rdpowers/OHMC2022/Hardware/Documents/FPGAPinMap.ods

Pin Number | Pin Name Kicad Library | PKL Lattice Lib | Function | Power Bank | Voltage Level | Primary | Secondary | OHMC2022 Proposed | FOMU | iCEBreaker Bitsy | COMMENT
1 | VCCIO_2 | VCCIO_2 | Power input |  |  |  |  |  |  |  |  | Matches FOMU
2 | IOB_6a | IOB_6A | Bidirectional | VCCIO_2 |  |  |  |  |  |  |  | Deviates FOMU
3 | IOB_9b | IOB_9B | Bidirectional | VCCIO_2 |  |  |  |  | TOUCH1 |  |  | New function not in FOMU
4 | IOB_8a | IOB_8A | Bidirectional | VCCIO_2
5 | VCC | VCC | Power input
6 | IOB_13b | IOB_13B | Bidirectional
7 | CDONE | CDONE | Open collector | SPI_VCCIO_1 | 3.3 |  |  | SAO PIN5 | CDONE |  | Wired to ESP32 so we can know programming status, can be a general IO in user function?? Includes weak pull-up to vccio_1
8 | ~CRESET | CRESET_B | Input | SPI_VCCIO_1 | 3.3 |  |  | SAO PIN6 | ~CRESET |  | Wired to ESP32 so we can kick the FPGA, drive externally or pullup to vccio_1
9 | IOB_16a | IOB_16A | Bidirectional
10 | IOB_18a | IOB_18A | Bidirectional
11 | IOB_20a | IOB_20A | Bidirectional
12 | IOB_22b | IOB_22A | Bidirectional |  |  |  |  |  |  |  | LATTICE LIBRARY COMPONENT HAS THIS AS IOB_22A, so does iCEBreaker.
13 | IOB_24a | IOB_24A | Bidirectional |  |  |  |  | Flash SPI IO3 Hold
14 | IOB_32a_SPI_SO | IOB_32a_SPI_SO | Bidirectional | SPI_VCCIO_1 | 3.3 |  |  | Flash SPI MOSI |  |  | Can be general I/O in user function
15 | IOB_34a_SPI_SCK | IOB_34a_SPI_SCK | Bidirectional | SPI_VCCIO_1 | 3.3 |  |  | Flash SPI SCK |  |  | Can be general I/O in user function
16 | IOB_35b_SPI_SS | IOB_35b_SPI_CSN | Bidirectional | SPI_VCCIO_1 | 3.3 |  |  | Flash SPI CS |  |  | Can be general I/O in user function
17 | IOB_33b_SPI_SI | IOB_33b_SPI_SI | Bidirectional | SPI_VCCIO_1 | 3.3 |  |  | Flash SPI MISO |  |  | Can be general I/O in user function
18 | IOB_31b | IOB_31B | Bidirectional | SPI_VCCIO_1
19 | IOB_29b | IOB_29B | Bidirectional | SPI_VCCIO_1
20 | IOB_25b_G3 | IOB_25B_G3 | Bidirectional | SPI_VCCIO_1 |  |  |  | Flash SPI IO2 WP
21 | IOB_23b | IOB_23B | Bidirectional | SPI_VCCIO_1
22 | SPI_VCCIO1 | SPI_VCCIO1 | Power input
23 | IOT_37a | IOT_37A | Bidirectional | VCCIO_0 |  |  |  | USB D-
24 | VPP_2V5 | VPP_2V5 | Power input
25 | IOT_36b | IOT_36B | Bidirectional | VCCIO_0 |  |  |  | USB D+
26 | IOT_39a | IOT_39A | Bidirectional | VCCIO_0 |  |  |  | PU_CTRL_USBP |  |  | Don’t have IOT_47a
27 | IOT_38b | IOT_38B | Bidirectional | VCCIO_0
28 | IOT_41a | IOT_41A | Bidirectional | VCCIO_0
29 | VCCPLL | VCCPLL | Power output
30 | VCC | VCC | Passive
31 | IOT_42b | IOT_42B | Bidirectional | VCCIO_0
32 | IOT_43a | IOT_43A | Bidirectional | VCCIO_0
33 | VCCIO_0 | VCCIO_0 | Power input
34 | IOT_44b | IOT_44B | Bidirectional | VCCIO_0
35 | IOT_46b_G0 | IOT_46B_G0 | Bidirectional | VCCIO_0 |  |  |  | INPUT CLOCK |  |  | We don’t have IOB_11b_G5 on this package like FOMU. Need to feed base clock to on of the *_G[0..7] lines. ICEBreaker used this pin @12MHz
36 | IOT_48b | IOT_48B | Bidirectional | VCCIO_0
37 | IOT_45a_G1 | IOT_45A_G1 | Bidirectional | VCCIO_0 |  |  |  |  |  | USB_DET
38 | IOT_50b | IOT_50B | Bidirectional | VCCIO_0 |  |  |  |  |  | USB D-
39 | RGB0 | RGB0 | Open collector |  |  |  |  | LED GREEN | LED GREEN
40 | RGB1 | RGB1 | Open collector |  |  |  |  | LED RED | LED RED
41 | RGB2 | RGB2 | Open collector |  |  |  |  | LED BLUE | LED BLUE
42 | IOT_51a | IOT_51A | Bidirectional | VCCIO_0 |  |  |  |  |  | USB D+
43 | IOT_49a | IOT_49A | Bidirectional | VCCIO_0
44 | IOB_3b_G6 | IOB_3B_G6 | Bidirectional | VCCIO_2 |  |  |  |  | TOUCH4
45 | IOB_5b | IOB_5B | Bidirectional | VCCIO_2
46 | IOB_0a | IOB_0A | Bidirectional | VCCIO_2 |  |  |  |  | TOUCH3
47 | IOB_2a | IOB_2A | Bidirectional | VCCIO_2 |  |  |  |  | TOUCH2
48 | IOB_4a | IOB_4A | Bidirectional | VCCIO_2
49 | GND | PAD/GND | Power input |  | 0
 |  |  |  |  |  | MISSING vs. FOMU |  | IOB_11b_G5 | OSC Input on SPI BANK, global clock
 |  |  |  |  |  |  |  | IOT_47a | PU_CTRL_USBP
 |  |  |  |  |  | TBA |  | i2s | Probably anywhere. Would be nice if mclk was possible on Global pin..
 |  |  |  |  |  |  |  | i2c | From ESP32, probably anywhere.
 |  |  |  |  |  |  |  | prototype | Can go anywhere. Connector? Pads?
 |  |  |  |  |  |  |  | i2c | Secondary FPGA master.
 |  |  |  |  |  |  |  | PU_CTRL_USBP/USB_DET
