rdpowers/OHMC2022/Hardware/Resources/PAM2306-VOTable.png

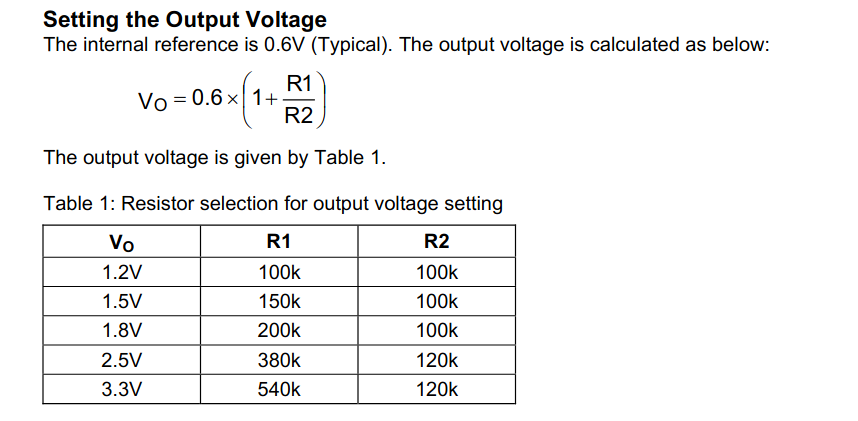
Hardware/Resources/PAM2306-VOTable.png
