rdpowers/OHMC2022/Hardware/Models/CW_SlideSwitch_GF-123-0054.step

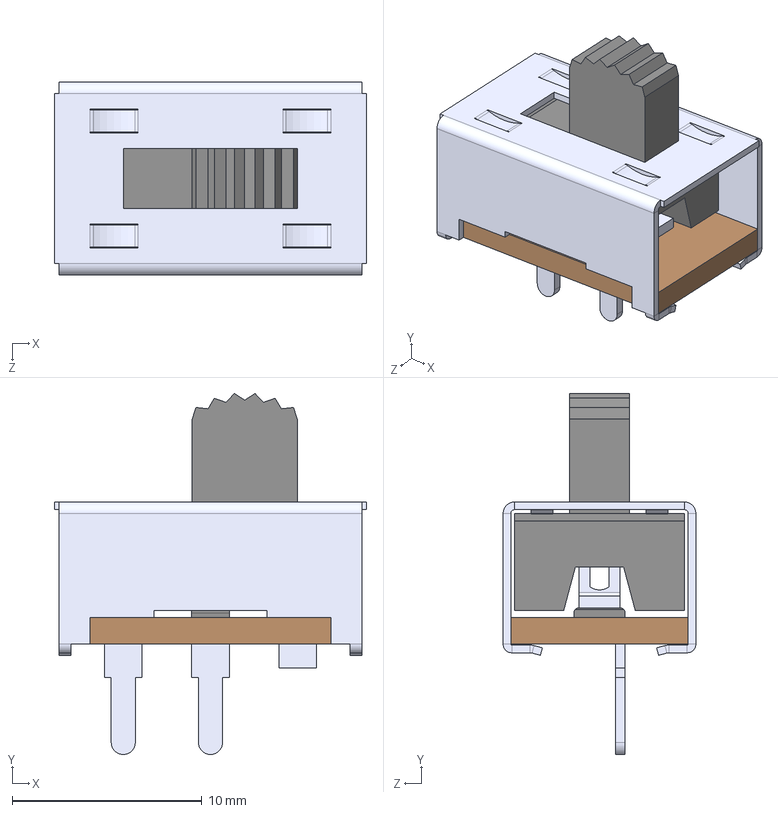
[picture p2: CAD file, 2021-09-02]
Hardware/Models/CW_SlideSwitch_GF-123-0054.step
16.5 x 19.0 x 10.2 mm
