rdpowers/OHMC2022/Hardware/Models/TRANS_EM6_ROM.SOT563.step

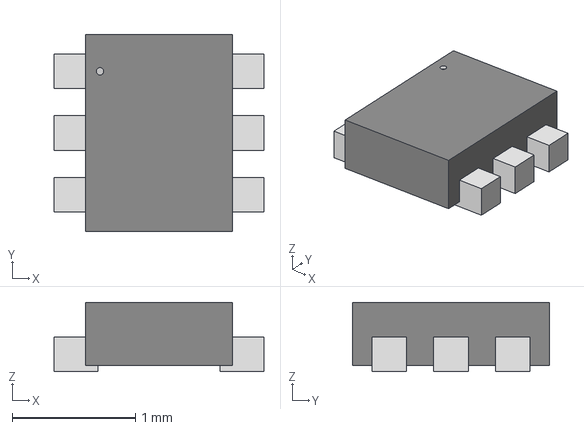
[picture p3: CAD file, 2021-09-02]
Hardware/Models/TRANS_EM6_ROM.SOT563.step
1.70 x 1.60 x 0.561 mm
