rdpowers/OHMC2022/Hardware/Models/TriLED.XZMDKCBDDG45S-9.step

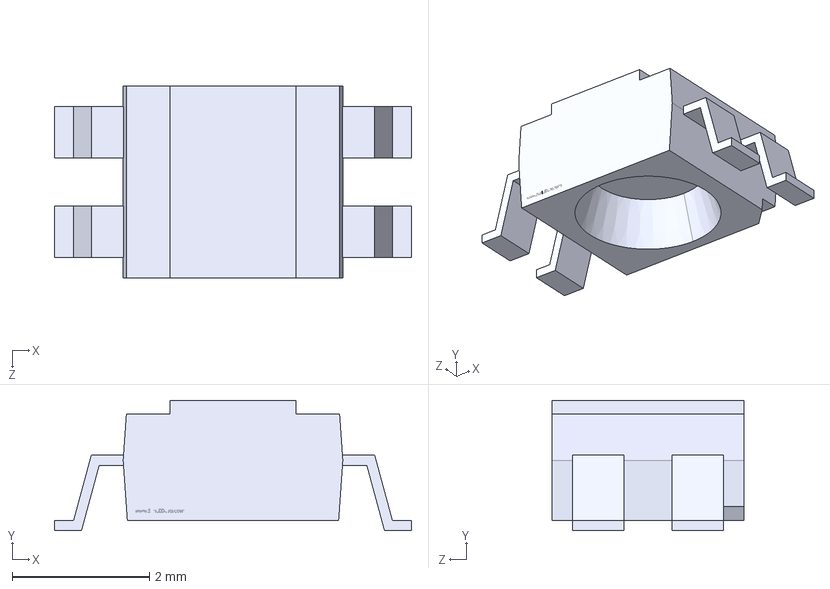
[picture p4: CAD file, 2021-08-31]
Hardware/Models/TriLED.XZMDKCBDDG45S-9.step
5.20 x 1.90 x 2.80 mm
