rdpowers/OHMC2022/Hardware/Models/19-337C_RSBHGHC-A88_4T.step

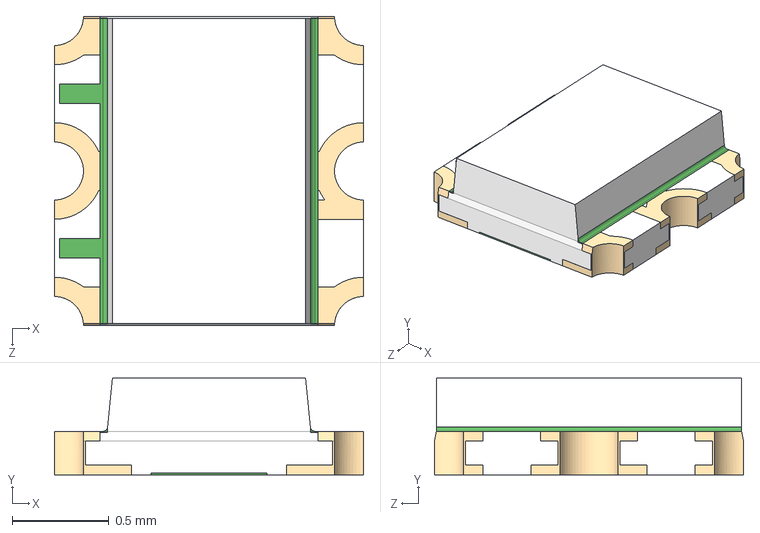
[picture p5: CAD file, 2021-08-30]
Hardware/Models/19-337C_RSBHGHC-A88_4T.step
1.60 x 0.5 x 1.60 mm
