rdpowers/OHMC2022/Hardware/Models/CUI_DEVICES_DS01-254-S-02BE.step

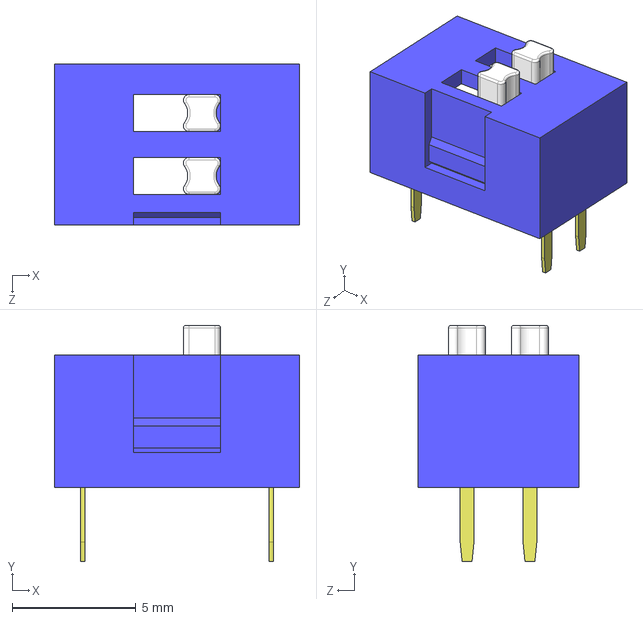
[picture p6: CAD file, 2021-08-30]
Hardware/Models/CUI_DEVICES_DS01-254-S-02BE.step
9.90 x 9.55 x 6.50 mm
