rdpowers/OHMC2022/Hardware/Models/EVQ-P7J01P.step

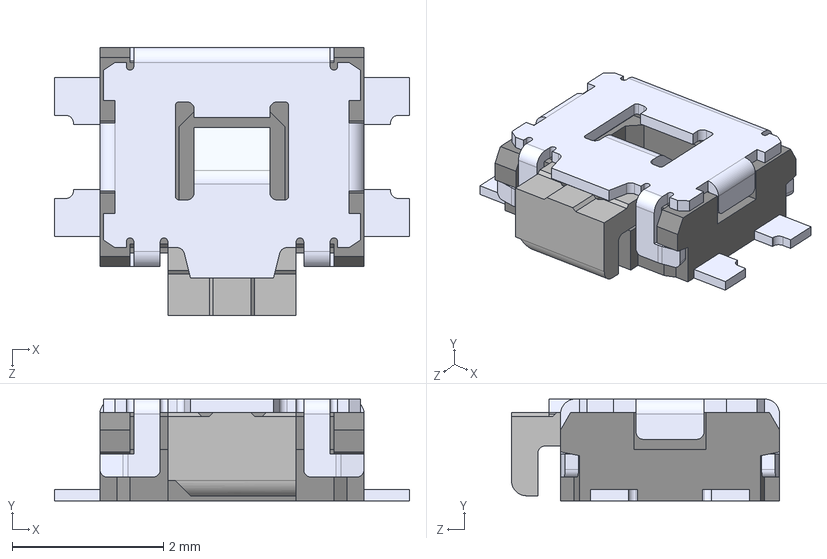
[picture p7: CAD file, 2021-08-29]
Hardware/Models/EVQ-P7J01P.step
4.70 x 1.35 x 3.55 mm
