rdpowers/OHMC2022/Hardware/Models/srn4018-4r7m.stp

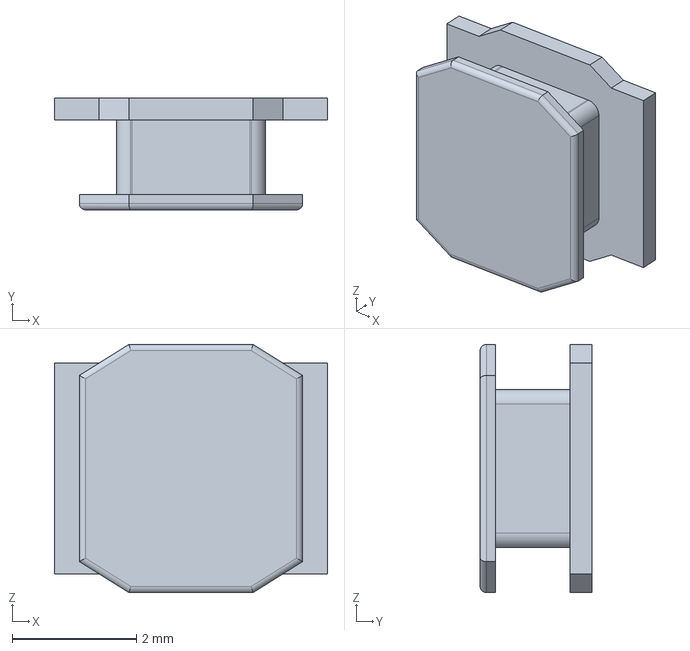
[picture p8: CAD file, 2021-08-29]
Hardware/Models/srn4018-4r7m.stp
4.40 x 1.80 x 4.00 mm
