rdpowers/OHMC2022/Hardware/Models/TSSOP14.HEF4069UBTT,118.STEP

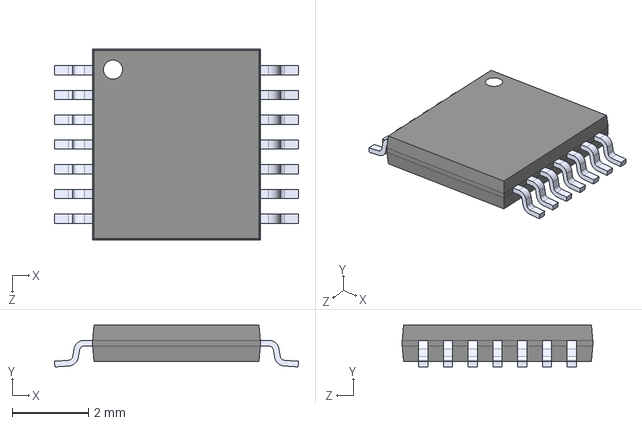
[picture p9: CAD file, 2021-08-28]
Hardware/Models/TSSOP14.HEF4069UBTT,118.STEP
6.40 x 1.10 x 5.00 mm
