rdpowers/OHMC2022/Hardware/Models/QFN50P250X350X100-17N.step

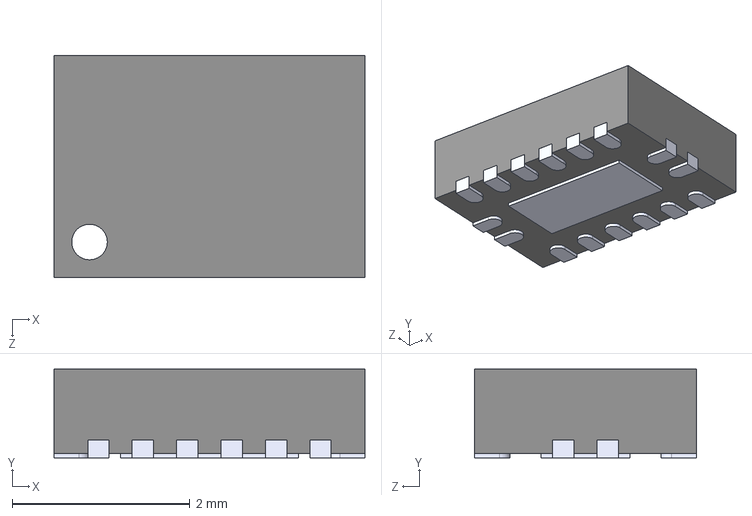
[picture p10: CAD file, 2021-08-28]
Hardware/Models/QFN50P250X350X100-17N.step
3.50 x 1.00 x 2.50 mm
