rdpowers/OHMC2022/Hardware/Models/IND_NL4532_TDK.step

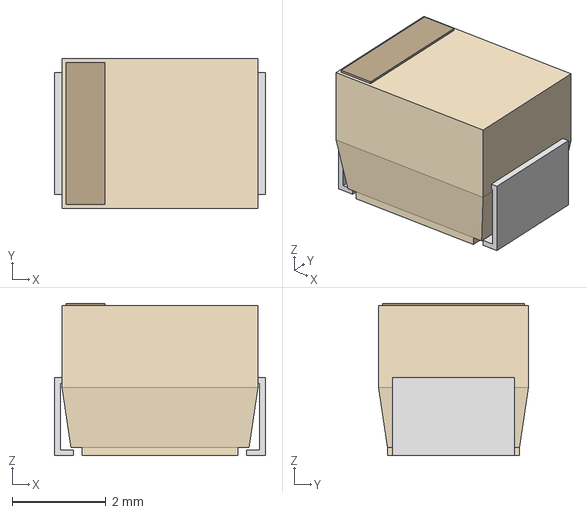
[picture p11: CAD file, 2021-08-28]
Hardware/Models/IND_NL4532_TDK.step
4.50 x 3.20 x 3.25 mm
