rdpowers/OHMC2022/Hardware/Models/Molex.uUSB-B.1050170001.stp

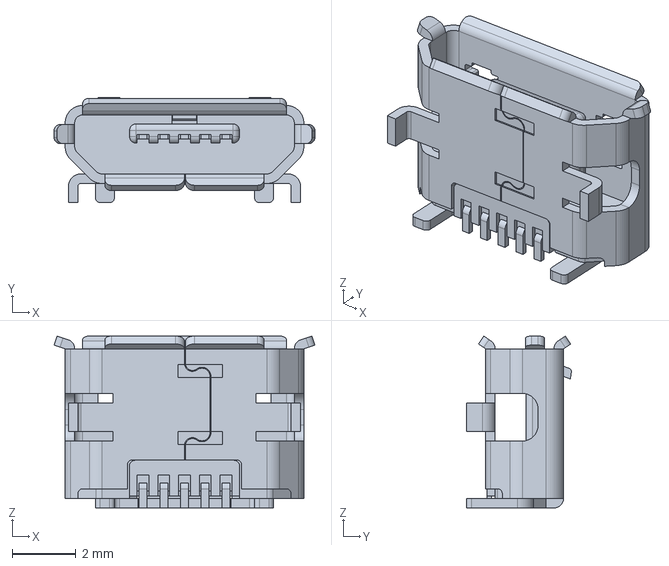
[picture p12: CAD file, 2021-08-27]
Hardware/Models/Molex.uUSB-B.1050170001.stp
8.20 x 3.30 x 5.40 mm
