rdpowers/OHMC2022/(threads)

Thread 2 (2021-10-03):

i2c0 net disconnect on top level sheet

rdpowers, 2021-10-03:
Missing net labels on top sheet means i2c0 doesn't go from SAO+ connector to FPGA/AFE blocks.

Closed 2021-11-08.

Thread 4 (2021-10-10):

Clock pin doesn't seem usable.

rdpowers, 2021-10-10:
Unresolved question about why _G0 pin doesn't pass synthesis. Other tested options are _G1 & _G3 on revision if this isn't remediated.

Closed 2021-11-08.

Thread 5 (2021-10-10):

Traces around USB connector.

rdpowers, 2021-10-10:
They're OK, but look weird. Fix them.

Closed 2021-11-08.

Thread 12 (2021-11-01):

Junction on L802 shouldn't be there.

rdpowers, 2021-11-01:
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

Guessing this got automatically added because the wire overlaps the pin? Awesome.

rdpowers, 2021-11-02:
Junction referenced is on Pin 1 of L802.

This line can be cut on the prototype.
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

Closed 2021-11-08.

Thread 13 (2021-11-08):

Did I fix the LED pinout issue?

rdpowers, 2021-11-08:

Closed 2021-11-08.
