rdpowers/OHMC2022/(commit log)

2021-08-22 Should probably put things in version control.
    [AFE.sch, Amplifier.sch, Audio.sch, Codec.sch, Connectors.sch, FPGA.sch, FPGAPinMap.ods, Power.sch]
2021-08-26 Getting down structure, some components created.
    [AFE.sch, Amplifier.sch, Audio.sch, Codec.sch, Connectors.sch, FPGA.sch, FPGAPinMap.ods, Power.sch]
2021-08-26 Checking in some libraries.
    [AFE.sch, FPGA.sch, Rockling.kicad_pcb, Rockling.sch]
2021-08-26 Moving some components around.
    [AFE.sch, FPGA.sch, Rockling.kicad_pcb, Rockling.sch]
2021-08-27 Adding libraries for TRRS.
    [FPGA.sch, Molex.uUSB-B.1050170001.stp, Rockling.kicad_pcb, Rockling.sch]
2021-08-27 Cleaning up a few associations, changing 0805 to 0603 footprints on AFE.
    [AFE.sch, Amplifier.sch, Audio.sch, Codec.sch, FPGA.sch, Power.sch, Rockling.kicad_pcb, Rockling.sch]
2021-08-28 Cleaning up some more, adding sourcing information.
    [AFE.sch, Rockling.kicad_pcb, Rockling.sch]
2021-08-28 Updating 4069 device to TSSOP14 package.
    [AFE.sch, IND_NL4532_TDK.step, QFN50P250X350X100-17N.step, TSSOP14.HEF4069UBTT,118.STEP]
2021-08-29 Adding in some power circuitry.
    [Power.sch, Rockling.sch]
2021-08-29 Now putting in power and passives.
    [Amplifier.sch, Power.sch, srn4018-4r7m.stp]
2021-08-29 Adding in a little more on the power circuitry, vreg for 2v5 rail.
    [Power.sch]
2021-08-29 We're going to need a bigger boat.
    [Power.sch, Rockling.kicad_pcb, Rockling.sch]
2021-08-29 Prospecting the layout of AFE, detailing connectors to larger board size.
    [EVQ-P7J01P.step, Power.sch, Rockling.kicad_pcb, Rockling.sch]
2021-08-29 Adding power to the 4069.
    [AFE.sch, Rockling.kicad_pcb, Rockling.sch]
2021-08-30 Checking in bits.
    [AFE.sch, FPGA.sch, Rockling.kicad_pcb, Rockling.sch]
2021-08-30 Adding 2-DIP switch.
    [CUI_DEVICES_DS01-254-S-02BE.step, FPGA.sch, Rockling.kicad_pcb, Rockling.sch]
2021-08-30 Adding some connectivity.
    [Audio.sch, Codec.sch, FPGA.sch, Rockling.kicad_pcb, Rockling.sch]
2021-08-30 Some passives to codec.
    [19-337C_RSBHGHC-A88_4T.step, Audio.sch, Codec.sch, Rockling.sch]
2021-08-30 Power connectivity going in.
    [Amplifier.sch, Codec.sch, Power.sch, Rockling.sch]
2021-08-31 Putting in some connectivity. More passives.
    [Amplifier.sch, Codec.sch, FPGA.sch, Power.sch, Rockling.kicad_pcb, Rockling.sch]
2021-08-31 More passives.
    [Audio.sch, Codec.sch, FPGA.sch, Power.sch, Rockling.kicad_pcb, Rockling.sch]
2021-08-31 Option for tri-color reverse mount LED.
    [AFE.sch, Codec.sch, FPGA.sch, Rockling.kicad_pcb, Rockling.sch, TriLED.XZMDKCBDDG45S-9.step]
2021-09-01 Adding in MEMS microphone library components.
    [Audio.sch, Codec.sch, Rockling.kicad_pcb, Rockling.sch]
2021-09-02 Level shifting for DAC, some connectivity.
    [AFE.sch, Audio.sch, Codec.sch, FPGA.sch, Rockling.sch, TRANS_EM6_ROM.SOT563.step]
2021-09-02 Hooking up switches, some more connectivity.
    [AFE.sch, Amplifier.sch, Audio.sch, CW_SlideSwitch_GF-123-0054.step, FPGA.sch, Rockling.kicad_pcb, Rockling.sch]
2021-09-02 FPGA wiring.
    [FPGA.sch, Rockling.sch]
2021-09-02 Wiring up FPGA, picking pins.
    [AFE.sch, FPGA.sch, Rockling.kicad_pcb, Rockling.sch]
2021-09-03 Schematic has proposed pin mapping on FPGA.
    [AFE.sch, FPGA.sch, Rockling.kicad_pcb, Rockling.sch]
2021-09-03 Touching layout.
    [AFE.sch, Amplifier.sch, Audio.sch, Codec.sch, FPGA.sch, Power.sch, Rockling.kicad_pcb, Rockling.sch]
2021-09-03 Doing up some layout. Going to change SAO header to match.
    [AFE.sch, Amplifier.sch, Audio.sch, Codec.sch, FPGA.sch, Power.sch, Rockling.kicad_pcb, Rockling.sch]
2021-09-04 Connecting up SAO.
    [AFE.sch, Amplifier.sch, Audio.sch, Codec.sch, FPGA.sch, Power.sch, Rockling.kicad_pcb, Rockling.sch]
2021-09-04 Commit before branch to fix VIN=3v3 from SAO.
    [Amplifier.sch, FPGA.sch, Rockling.kicad_pcb, Rockling.sch]
2021-09-04 Think this is close to fixing the power circuitry.
    [AFE.sch, Amplifier.sch, Power.sch]
2021-09-04 Commit berfore merge back with power fix.
    [Codec.sch, FPGA.sch, Power.sch, Rockling.kicad_pcb]
2021-09-04 Fixing up some BoM repetition.
    [AFE.sch, Amplifier.sch, Codec.sch, Power.sch, Rockling.kicad_pcb]
2021-09-05 Doing some layout of the Theremin AFE.
    [Rockling.kicad_pcb]
2021-09-05 AFE blocks are laid out and should be able to fit in. Leaving them off to the side for block selection later.
    [Rockling.kicad_pcb]
2021-09-05 Placements mostly done.
    [AFE.sch, FPGA.sch, Rockling.kicad_pcb, Rockling.sch]
2021-09-05 More placements, shaping up.
    [Rockling.kicad_pcb]
2021-09-05 Most placements, testpoints and spare points added. Looking good.
    [AFE.sch, Codec.sch, FPGA.sch, Rockling.kicad_pcb, Rockling.sch]
2021-09-05 Nothing to see here.
    [FPGA.sch, Rockling.kicad_pcb, Rockling.sch]
2021-09-05 Backfeed enabled.
    [AFE.sch, Amplifier.sch, Audio.sch, Codec.sch, Power.sch, Rockling.kicad_pcb]
2021-09-06 Adding in extra decoupling.
    [Codec.sch, FPGA.sch, Power.sch, Rockling.kicad_pcb, Rockling.sch]
2021-09-06 Changing off slide switch for unpopulated TH.
    [FPGA.sch, Rockling.kicad_pcb, Rockling.sch]
2021-09-06 Adding power LED.
    [Rockling.kicad_pcb, Rockling.sch]
2021-09-06 Spare points on r=26.5mm @ x1.27mm linear separation.
    [AFE.sch, Codec.sch, FPGA.sch, Rockling.kicad_pcb, Rockling.sch]
2021-09-06 Doing finer aspirational placements.
    [AFE.sch, FPGA.sch, Rockling.kicad_pcb, Rockling.sch]
2021-09-06 Starting routing.
    [Rockling.kicad_pcb]
2021-09-06 Trying to add suppliers in Altium formats.
    [AFE.sch, Amplifier.sch, Codec.sch, FPGA.sch, Power.sch, Rockling.sch]
2021-09-06 Saving PCB?
    [Rockling.kicad_pcb]
2021-09-07 Routing going in now.
    [AFE.sch, FPGA.sch, Rockling.kicad_pcb, Rockling.sch]
2021-09-07 Better connect up that button..
    [FPGA.sch, Rockling.kicad_pcb, Rockling.sch]
2021-09-07 Cleaning up some traces.
    [AFE.sch, Rockling.kicad_pcb]
2021-09-07 All connected.
    [Rockling.kicad_pcb, Rockling.sch]
2021-09-07 Finer layout touches.
    [Rockling.kicad_pcb]
2021-09-07 Putting down some final touches on layout, initial DRC.
    [Power.sch, Rockling.kicad_pcb, Rockling.sch]
2021-09-07 More touching up.
    [Rockling.kicad_pcb]
2021-09-07 Touches, overlays.
    [Power.sch, Rockling.kicad_pcb, Rockling.sch]
2021-09-08 One or two overlays.
    [Rockling.kicad_pcb]
2021-09-08 Cleaning up some libraries, better if those pins are connected.
    [Codec.sch, FPGA.sch, Power.sch, Rockling.kicad_pcb, Rockling.sch]
2021-09-08 Not too much different.
    [Rockling.kicad_pcb]
2021-09-08 And just cleaning up the power flags a little.
    [Power.sch, Rockling.sch]
2021-09-08 Ok, stop pushing the tracks around needlessly.
    [Rockling.kicad_pcb]
2021-09-09 Changing around the audio inputs.
    [Audio.sch, Codec.sch, Rockling.kicad_pcb, Rockling.sch]
2021-09-09 Adding resistor to line-in just in case.
    [Codec.sch, Rockling.sch]
2021-09-09 Going to regenerate BoM.
    [Codec.sch, Rockling.kicad_pcb]
2021-09-09 BoM freeze for prototype.
    [AFE.sch, FPGA.sch, Rockling.BoM.csv]
2021-09-10 First pass of Gerbers.
    [Rockling-B_Cu.gbl, Rockling-B_Mask.gbs, Rockling-B_Paste.gbp, Rockling-B_SilkS.gbo, Rockling-Edge_Cuts.gm1, Rockling-F_Cu.gtl, Rockling-F_Mask.gts, Rockling-F_Paste.gtp]
2021-09-10 Updating back overlay.
    [Rockling.kicad_pcb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]
2021-10-03 Adding ibom for assembly/reference.
2021-11-03 Commit before branch for v1.0 fixes.
    [AFE.sch]
2021-11-03 Do we need to store all of this? Probably should.
    [OpenThereminCC.sch, icebreaker-bitsy.sch, tomu-fpga.sch]
2021-11-03 Moved off that junction. Fixes #12.
    [Rockling.kicad_pcb]
2021-11-03 Adding pull-ups for i2c1 as in #9. Needs layout still.
    [FPGA.sch]
2021-11-03 Schematic changes for DDS experiment for #7. Needs layout.
    [AFE.sch]
2021-11-03 Schematic changes for i2c0 disconnect. Fixes #2, needs layout.
    [FPGA.sch, Rockling.kicad_pcb, Rockling.sch]
2021-11-03 Move DAC i2c bus. Fixes #10, needs layout.
    [AFE.sch, FPGA.sch, Rockling.kicad_pcb, Rockling.sch]
2021-11-08 Correcting for the LED pinout error that was due to the datasheet. Fixes #13.
    [Rockling.kicad_pcb]
2021-11-08 Dummy commit, fixes #9 fixes #7. Fixes #12 which was fixed by #7 anyway.
    [Rockling.kicad_pcb]
2021-11-08 Changed USB ESD to SOT723, fixes #6.
    [FPGA.sch, Rockling.kicad_pcb]
2021-11-08 Layout around USB lines, fixes #5.
    [Rockling.kicad_pcb]
2021-11-08 Swapping clock pin that should have worked for one that did. Fixes #4.
    [FPGA.sch, Rockling.kicad_pcb]
2021-11-08 Positions on the board. Connectivity next.
    [Rockling.kicad_pcb]
2021-11-08 Just a few more lines to connect up.
    [Rockling.kicad_pcb]
2021-11-08 Just needs clean-up & DRC, checks.
    [Rockling.kicad_pcb]
2021-11-09 Passes DRC, unconnected.
    [Rockling.kicad_pcb]
2021-11-09 Make sure DRC doesn't fill back in the pours.
    [Rockling.kicad_pcb]
2021-11-09 Minor fixes found on checks. First Gerbers coming up.
    [Rockling.kicad_pcb]
2021-11-09 First Gerbers that look good.
    [Rockling-B_Cu.gbl, Rockling-B_Mask.gbs, Rockling-B_Paste.gbp, Rockling-B_SilkS.gbo, Rockling-Edge_Cuts.gm1, Rockling-F_Cu.gtl, Rockling-F_Mask.gts, Rockling-F_Paste.gtp]
2021-11-09 Candidate Gerbers for v1.0.
    [Rockling-B_Cu.gbl, Rockling-B_Mask.gbs, Rockling-B_Paste.gbp, Rockling-B_SilkS.gbo, Rockling-Edge_Cuts.gm1, Rockling-F_Cu.gtl, Rockling-F_Mask.gts, Rockling-F_Paste.gtp]
